aamott/Arduinifit/(commit log)

2024-03-27 Initial code commit
    Code and basic wiring. Uses delay statements rather than time checker.
2024-03-27 rename main file for Arduino IDE compatibility
2024-03-30 use timers instead of delays
2024-03-30 allow inverting buttons
